dougsthenri/spindle_driver_v1-1/README.md

# spindle_driver Version 1.1
PCB project for a BLDC motor driver tailored for CNC spindle motors.

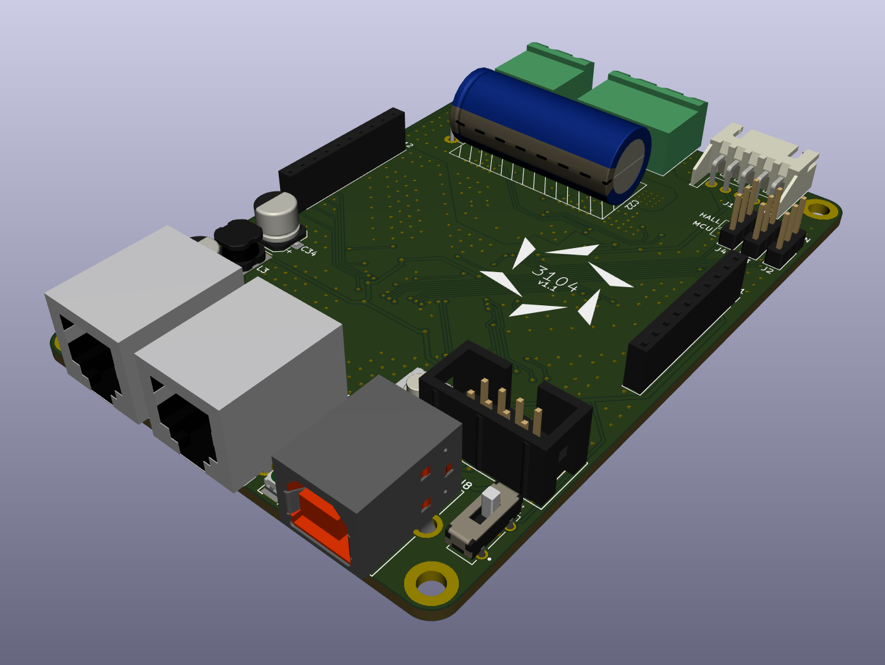
[picture p1: spindle_driver_v1.1.png]
PCB rendering
