dougsthenri/spindle_driver_v1-1/spindle_driver.kicad_pcb

## KiCad design spindle_driver.kicad_pcb (2025-04-03)

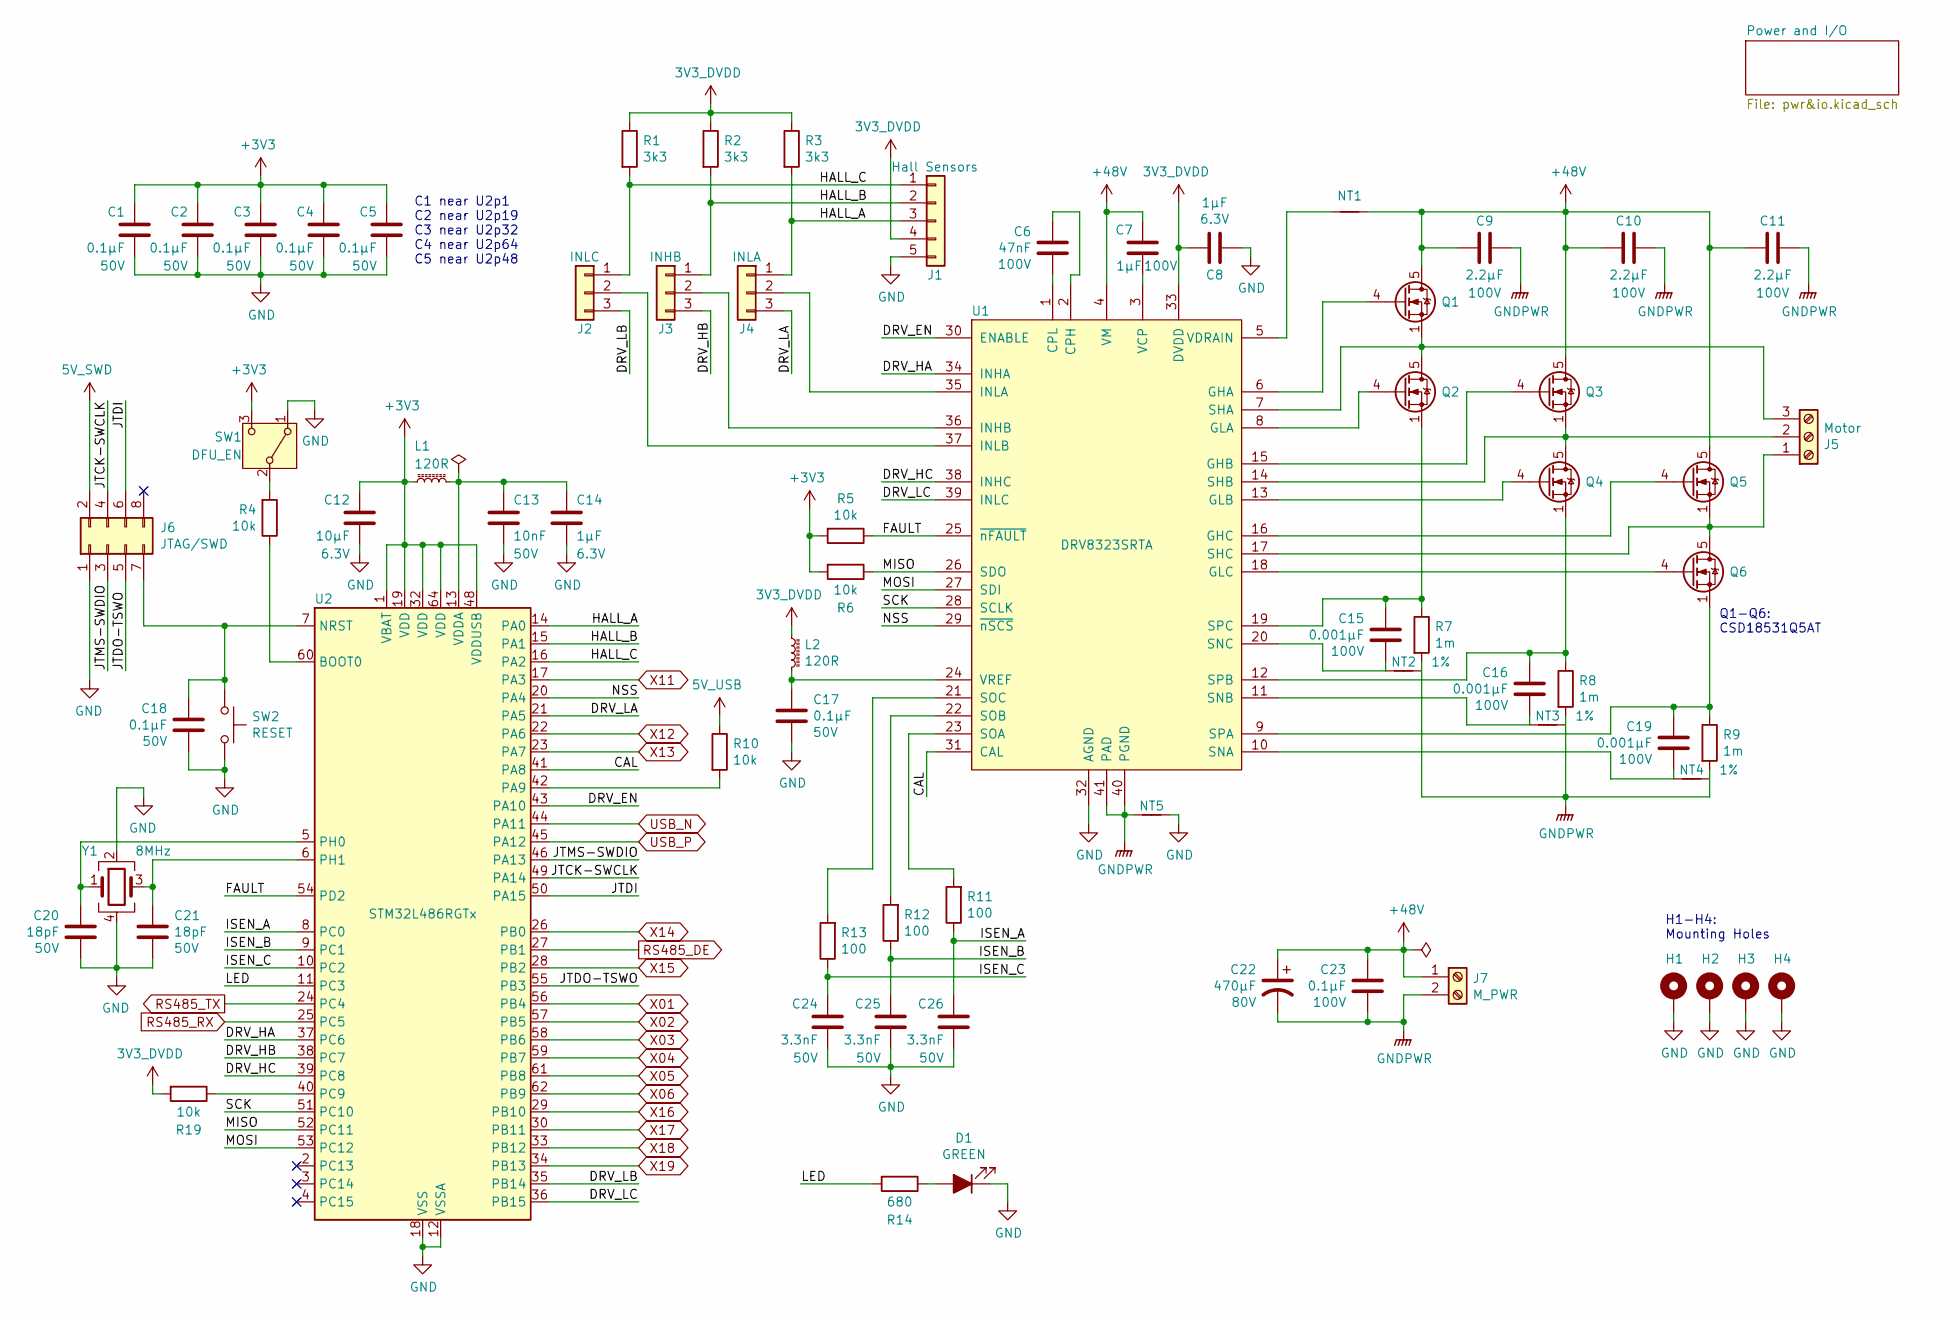
[picture p2: schematic spindle_driver.kicad_sch, Project 3104]

Parts:
C1, C2, C3, C4, C5, C17, C18: 0.1µF; C_0805_2012Metric; Voltage 50V; Part# C0805C104K5RACTU
C6: 47nF; C_1812_4532Metric; Voltage 100V; Part# C1812C473K1RACTU
C7: 1µF; C_1206_3216Metric; Voltage 100V; Part# CL31B105KCHNNNE
C8, C14: 1µF; C_0603_1608Metric; Voltage 6.3V; Part# CL10B105KQ8NNNC
C9, C10, C11: 2.2µF; C_1210_3225Metric; Voltage 100V; Part# 12101C225K4T2A
C12: 10µF; CP_EIA-3216-18_Kemet-A; Voltage 6.3V; Part# T491A106K006AT
C13: 10nF; C_0805_2012Metric; Voltage 50V; Part# CC0805KRX7R9BB103
C15, C16, C19: 0.001µF; C_0805_2012Metric; Voltage 100V; Part# CC0805JRX7R0BB102
C20, C21: 18pF; C_0603_1608Metric; Voltage 50V; Part# CL10C180FB8NNNC
C22: 470µF; EEU-FS1K471L; Voltage 80V; Part# EEU-FS1K471L
C23: 0.1µF; C_1206_3216Metric; Voltage 100V; Part# CC1206JKX7R0BB104
C24, C25, C26: 3.3nF; C_0805_2012Metric; Voltage 50V; Part# CL21C332JBFNNNF
D1: GREEN; LED_PLCC-2; Part# VLMC3101-GS08
H1, H2, H3, H4: MountingHole_Pad; MountingHole_3.2mm_M3_DIN965_Pad
J1: Hall Sensors; JST_XH_S5B-XH-A_1x05_P2.50mm_Horizontal_Protruded; Part# S5B-XH-A(LF)(SN)
J2: INLC; PinHeader_1x03_P2.54mm_Vertical
J3: INHB; PinHeader_1x03_P2.54mm_Vertical
J4: INLA; PinHeader_1x03_P2.54mm_Vertical
J5: Motor; PhoenixContact_MSTBA_2,5_3-G-5,08_1x03_P5.08mm_Horizontal_P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; Part# MSTBA 2.5/ 3-G-5.08
J6: JTAG/SWD; IDC-Header_2x04_P2.54mm_Vertical; Part# BHR-08-VUA
J7: M_PWR; PhoenixContact_MSTBA_2,5_2-G-5,08_1x02_P5.08mm_Horizontal; Part# MSTBA 2.5/ 2-G-5.08
L1, L2: 120R; L_0805_2012Metric; Part# MLS0805-4S7-121
NT1, NT2, NT3, NT4, NT5: Net-Tie_2; NetTie-2_SMD_Pad0.25mm
Q1, Q2, Q3, Q4, Q5, Q6: CSD18531Q5A; TDSON-8-1
R1, R2, R3: 3k3; R_0805_2012Metric; Part# CRCW08053K30JNEA
R4, R5, R6, R10, R19: 10k; R_0805_2012Metric; Part# RC0805JR-0710KL
R7, R8, R9: 1m; R_2512_6332Metric; Tolerance 1%; Part# ERJ-MS4SF1M0U
R11, R12, R13: 100; C_0805_2012Metric; Part# CRGCQ0805J100R
R14: 680; R_0805_2012Metric; Part# RC0805FR-07680RL
SW1: DFU_EN; Alps_SSSS213000; Part# SSSS213000
SW2: RESET; SW_SPST_EVQQ2; Part# EVQ-Q2Y03W
U1: DRV8323SRTA; Texas_S-PWQFN-N40; Part# DRV8323SRTAR
U2: STM32L486RGTx; LQFP-64_10x10mm_P0.5mm
Y1: 8MHz; Crystal_SMD_3225-4Pin_3.2x2.5mm; Part# 12.60028

Connections:
3V3_DVDD: C8.1, J1.4, L2.1, R1.1, R2.1, R3.1, R19.2, U1.33 (DVDD)
5V_SWD: J6.2; also elsewhere on the board
5V_USB: R10.1; also elsewhere on the board
+3V3: C1.1, C2.1, C3.1, C4.1, C5.1, C12.1, L1.1, R5.2, R6.2, SW1.3 (C), U2.1 (VBAT), U2.19 (VDD), U2.32 (VDD), U2.48 (VDDUSB), U2.64 (VDD); also elsewhere on the board
+48V: C7.1, C9.2, C10.2, C11.2, C22.1, C23.2, J7.1, NT1.2, Q1.5 (D), Q3.5 (D), Q5.5 (D), U1.4 (VM)
/CAL: U1.31 (CAL), U2.41 (PA8)
/DRV_EN: U1.30 (ENABLE), U2.43 (PA10)
/DRV_HA: U1.34 (INHA), U2.37 (PC6)
/DRV_HB: J3.3, U2.38 (PC7)
/DRV_HC: U1.38 (INHC), U2.39 (PC8)
/DRV_LA: J4.3, U2.21 (PA5)
/DRV_LB: J2.3, U2.35 (PB14)
/DRV_LC: U1.39 (INLC), U2.36 (PB15)
/FAULT: R5.1, U1.25 (~nFAULT), U2.54 (PD2)
/HALL_A: J1.3, J4.1, R3.2, U2.14 (PA0)
/HALL_B: J1.2, J3.1, R2.2, U2.15 (PA1)
/HALL_C: J1.1, J2.1, R1.2, U2.16 (PA2)
/ISEN_A: C26.1, R11.1, U2.8 (PC0)
/ISEN_B: C25.1, R12.1, U2.9 (PC1)
/ISEN_C: C24.1, R13.1, U2.10 (PC2)
/JTCK-SWCLK: J6.4, U2.49 (PA14)
/JTDI: J6.6, U2.50 (PA15)
/JTDO-TSWO: J6.5, U2.55 (PB3)
/JTMS-SWDIO: J6.3, U2.46 (PA13)
/LED: R14.2, U2.11 (PC3)
/MISO: R6.1, U1.26 (SDO), U2.52 (PC11)
/MOSI: U1.27 (SDI), U2.53 (PC12)
/NSS: U1.29 (~nSCS), U2.20 (PA4)
/SCK: U1.28 (SCLK), U2.51 (PC10)
GND: C1.2, C2.2, C3.2, C4.2, C5.2, C8.2, C12.2, C13.2, C14.2, C17.2, C18.2, C20.1, C21.1, C24.2, C25.2, C26.2, D1.1 (K), H1.1, H2.1, H3.1, H4.1, J1.5, J6.1, NT5.2, SW1.1 (A), SW2.1, U1.32 (AGND), U2.12 (VSSA), U2.18 (VSS), U2.31 (VSS), U2.47 (VSS), U2.63 (VSS), Y1.2, Y1.4; also elsewhere on the board
GNDPWR: C9.1, C10.1, C11.1, C22.2, C23.1, J7.2, NT2.2, NT3.2, NT4.2, NT5.1, R7.2, R8.2, R9.2, U1.40 (PGND), U1.41 (PAD)
unnamed: C6.1, U1.1 (CPL)
unnamed: C6.2, U1.2 (CPH)
unnamed: C7.2, U1.3 (VCP)
unnamed: C13.1, C14.1, L1.2, U2.13 (VDDA)
unnamed: C15.1, NT2.1, U1.20 (SNC)
unnamed: C15.2, Q2.1 (S), Q2.2 (S), Q2.3 (S), R7.1, U1.19 (SPC)
unnamed: C16.1, NT3.1, U1.11 (SNB)
unnamed: C16.2, Q4.1 (S), Q4.2 (S), Q4.3 (S), R8.1, U1.12 (SPB)
unnamed: C17.1, L2.2, U1.24 (VREF)
unnamed: C18.1, J6.7, SW2.2, U2.7 (NRST)
unnamed: C19.1, NT4.1, U1.10 (SNA)
unnamed: C19.2, Q6.1 (S), Q6.2 (S), Q6.3 (S), R9.1, U1.9 (SPA)
unnamed: C20.2, U2.5 (PH0), Y1.1
unnamed: C21.2, U2.6 (PH1), Y1.3
unnamed: D1.2 (A), R14.1
unnamed: J2.2, U1.37 (INLB)
unnamed: J3.2, U1.36 (INHB)
unnamed: J4.2, U1.35 (INLA)
unnamed: J5.1, Q5.1 (S), Q5.2 (S), Q5.3 (S), Q6.5 (D), U1.17 (SHC)
unnamed: J5.2, Q3.1 (S), Q3.2 (S), Q3.3 (S), Q4.5 (D), U1.14 (SHB)
unnamed: J5.3, Q1.1 (S), Q1.2 (S), Q1.3 (S), Q2.5 (D), U1.7 (SHA)
unnamed: NT1.1, U1.5 (VDRAIN)
unnamed: Q1.4 (G), U1.6 (GHA)
unnamed: Q2.4 (G), U1.8 (GLA)
unnamed: Q3.4 (G), U1.15 (GHB)
unnamed: Q4.4 (G), U1.13 (GLB)
unnamed: Q5.4 (G), U1.16 (GHC)
unnamed: Q6.4 (G), U1.18 (GLC)
unnamed: R4.1, U2.60 (BOOT0)
unnamed: R4.2, SW1.2 (B)
unnamed: R10.2, U2.42 (PA9)
unnamed: R11.2, U1.23 (SOA)
unnamed: R12.2, U1.22 (SOB)
unnamed: R13.2, U1.21 (SOC)
unnamed: R19.1, U2.40 (PC9)
RS485_DE: U2.27 (PB1); also elsewhere on the board
RS485_RX: U2.25 (PC5); also elsewhere on the board
RS485_TX: U2.24 (PC4); also elsewhere on the board
X01: U2.56 (PB4); also elsewhere on the board
X02: U2.57 (PB5); also elsewhere on the board
X03: U2.58 (PB6); also elsewhere on the board
X04: U2.59 (PB7); also elsewhere on the board
X05: U2.61 (PB8); also elsewhere on the board
X06: U2.62 (PB9); also elsewhere on the board
X11: U2.17 (PA3); also elsewhere on the board
X12: U2.22 (PA6); also elsewhere on the board
X13: U2.23 (PA7); also elsewhere on the board
X14: U2.26 (PB0); also elsewhere on the board
X15: U2.28 (PB2); also elsewhere on the board
X16: U2.29 (PB10); also elsewhere on the board
X17: U2.30 (PB11); also elsewhere on the board
X18: U2.33 (PB12); also elsewhere on the board
X19: U2.34 (PB13); also elsewhere on the board

Notes on the sheet:
C1 near U2p1 C2 near U2p19 C3 near U2p32 C4 near U2p64 C5 near U2p48
H1-H4: Mounting Holes
Q1-Q6: CSD18531Q5AT

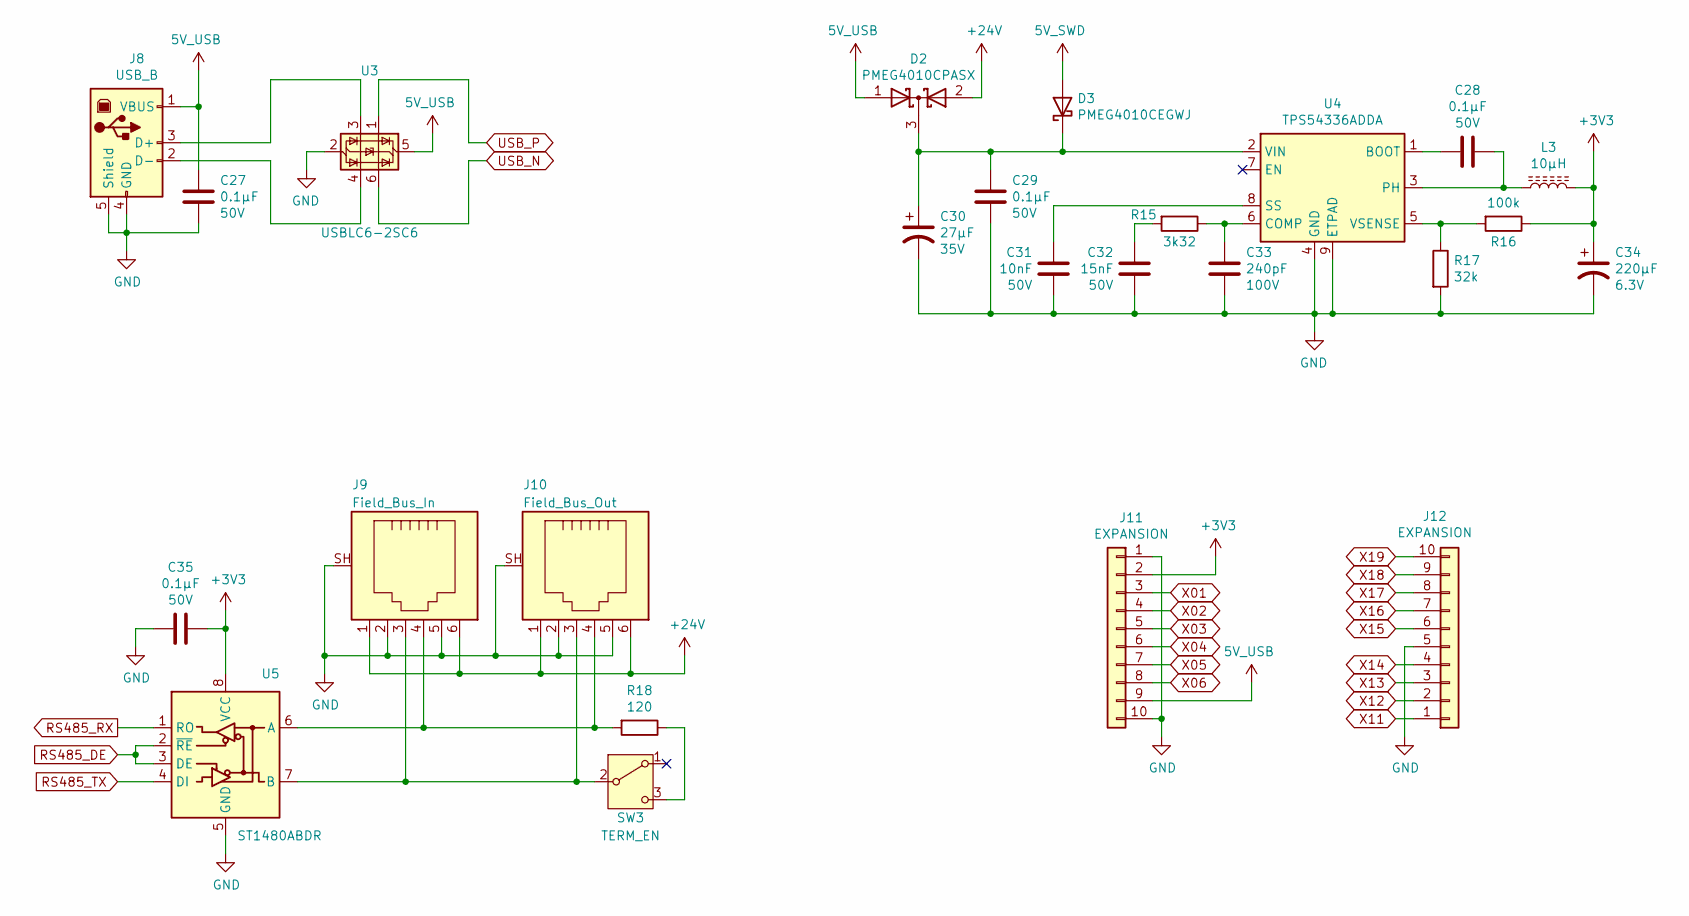
[picture p3: schematic pwr&io.kicad_sch, Project 3104]

Parts:
C27, C35: 0.1µF; C_0805_2012Metric; Voltage 50V; Part# C0805C104K5RACTU
C28, C29: 0.1µF; C_0805_2012Metric; Voltage 50V; Part# CC0805KRX7R9BB104
C30: 27µF; CP_Elec_6.3x5.8; Voltage 35V; Part# EEH-ZA1V270P
C31: 10nF; C_0805_2012Metric; Voltage 50V; Part# CC0805KRX7R9BB103
C32: 15nF; C_0805_2012Metric; Voltage 50V; Part# CGA4F2C0G1H153J085AA
C33: 240pF; C_0805_2012Metric; Voltage 100V; Part# GRM2165C2A241JA01D
C34: 220µF; CP_Elec_6.3x5.9; Voltage 6.3V; Part# 6SVPE220M
D2: PMEG4010CPASX; SOT1061
D3: PMEG4010CEGWJ; D_SOD-123
J8: USB_B; USB_B_Samtec_USBR-B-S-S-O-TH_Horizontal_Protruded; Part# USBR-B-S-S-O-TH
J9: Field_Bus_In; RJ12
J10: Field_Bus_Out; RJ12
J11, J12: EXPANSION; PinSocket_1x10_P2.54mm_Vertical; Part# SSW-110-01-T-S
L3: 10µH; SRN6045-100M; Part# SRN6045-100M
R15: 3k32; R_0805_2012Metric; Part# CRCW08053K32FKEA
R16: 100k; R_0805_2012Metric; Part# CRCW0805100KFKEA
R17: 32k; R_0805_2012Metric; Part# TNPW080532K0BETA
R18: 120; R_0805_2012Metric; Part# MC01W08055120R
SW3: TERM_EN; Alps_SSSS213000; Part# SSSS213000
U3: USBLC6-2SC6; SOT-23-6
U4: TPS54336ADDA; TI_SO-PowerPAD-8
U5: ST1480ABDR; SOIC-8_3.9x4.9mm_P1.27mm

Connections:
5V_SWD: D3.2 (A); also elsewhere on the board
5V_USB: C27.1, D2.1 (A), J8.1 (VBUS), J11.9, U3.5 (VBUS); also elsewhere on the board
+3V3: C34.1, C35.1, J11.2, L3.2, R16.1, U5.8 (VCC); also elsewhere on the board
+24V: D2.2 (A), J9.1, J9.6, J10.1, J10.6
GND: C27.2, C29.2, C30.2, C31.1, C32.1, C33.2, C34.2, C35.2, J8.4 (GND), J8.5 (Shield), J9.2, J9.5, J9.SH, J10.2, J10.5, J10.SH, J11.1, J11.10, J12.5, R17.2, U3.2 (GND), U4.4 (GND), U4.9 (ETPAD), U5.5 (GND); also elsewhere on the board
unnamed: C28.1, L3.1, U4.3 (PH)
unnamed: C28.2, U4.1 (BOOT)
unnamed: C29.1, C30.1, D2.3 (K), D3.1 (K), U4.2 (VIN)
unnamed: C31.2, U4.8 (SS)
unnamed: C32.2, R15.2
unnamed: C33.1, R15.1, U4.6 (COMP)
unnamed: R16.2, R17.1, U4.5 (VSENSE)
unnamed: R18.1, SW3.3 (C)
RS485_DE: U5.2 (~RE), U5.3 (DE); also elsewhere on the board
RS485_RX: U5.1 (RO); also elsewhere on the board
RS485_TX: U5.4 (DI); also elsewhere on the board
X01: J11.3; also elsewhere on the board
X02: J11.4; also elsewhere on the board
X03: J11.5; also elsewhere on the board
X04: J11.6; also elsewhere on the board
X05: J11.7; also elsewhere on the board
X06: J11.8; also elsewhere on the board
X11: J12.1; also elsewhere on the board
X12: J12.2; also elsewhere on the board
X13: J12.3; also elsewhere on the board
X14: J12.4; also elsewhere on the board
X15: J12.6; also elsewhere on the board
X16: J12.7; also elsewhere on the board
X17: J12.8; also elsewhere on the board
X18: J12.9; also elsewhere on the board
X19: J12.10; also elsewhere on the board

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
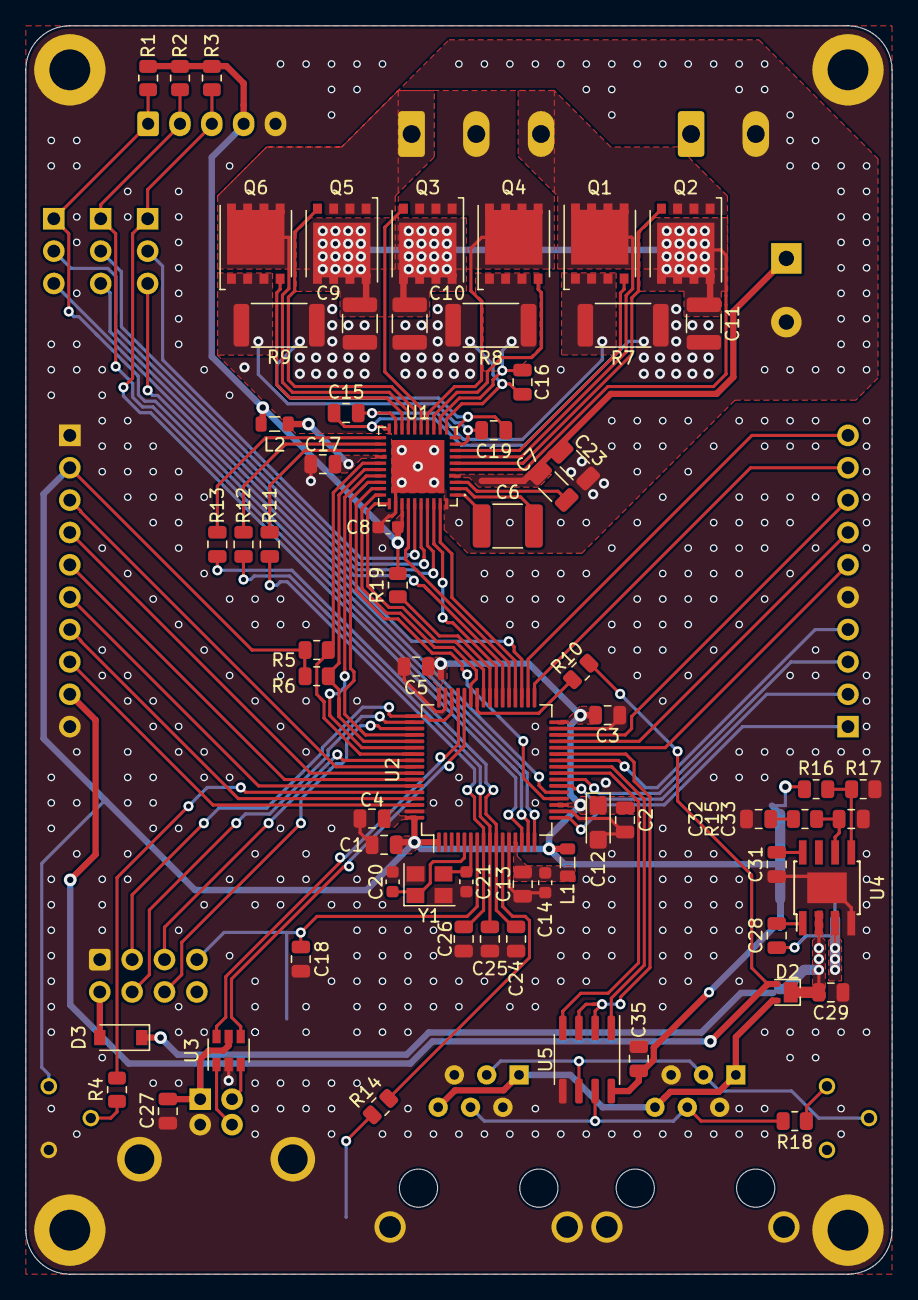
[picture p4: board spindle_driver.kicad_pcb from above]

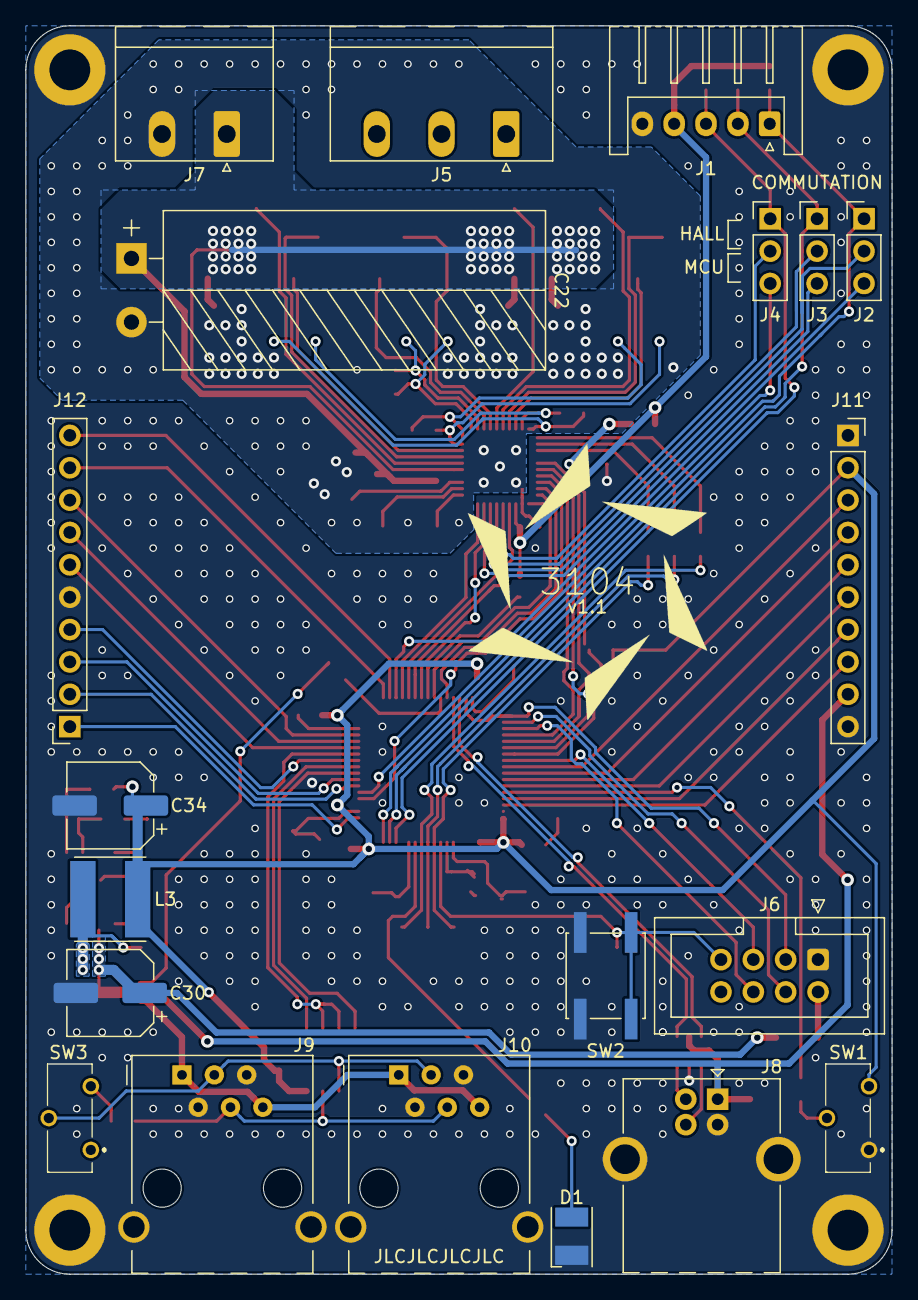
[picture p5: board spindle_driver.kicad_pcb from below]

Board: 2 copper layers, 68.0 x 98.0 mm, 97 parts (24 on the bottom side), 99 nets.

Other parts of the board:
G0: Project_ID_700dpi
