dougsthenri/spindle_driver_v1-1/(commit log)

2025-04-03 Updated project to Kicad 8
    [pwr&io.kicad_sch, pwr&io.sch, spindle_driver.kicad_pcb, spindle_driver.kicad_sch, spindle_driver.sch]
2025-04-03 Added project description
    [pwr&io.kicad_sch, spindle_driver.kicad_sch]
